gaetan-m11/TPI_TIME_TIMER/README.md

# TIME TIMER

## Description
Minuteur électronique réalisé dans le cadre d'un TPI

## Image
Capture d'écran 1

## Auteur
### Gaëtan Michel
### DIVTEC - ELT
### ELT 3+1
### 31.05.2024
