gaetan-m11/TPI_TIME_TIMER/Altium Designs/Circuit LED statut/LED_BAT_drawing.pdf

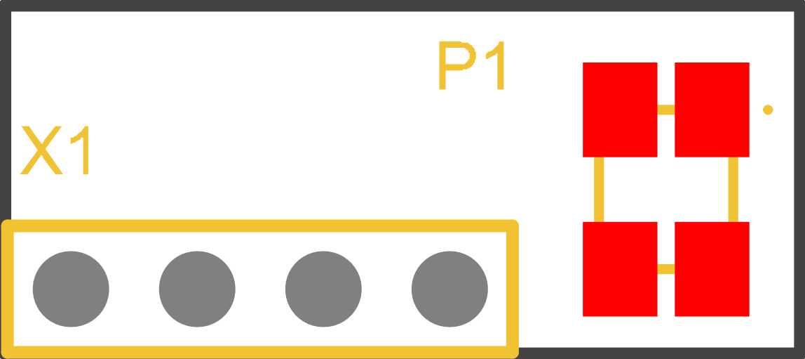
[picture p72: figure]
