gaetan-m11/TPI_TIME_TIMER/Documentation/Format PDF/TPI_Planning.pdf

ELT 3+1

# Planning TPI

Gaëtan Michel

S'informer | Lecture du CDC | initiale
| | Réel
| Recherche de solutions / composants | initiale
| | Réel
Absents, Maladie, … Planifier | création du Planning | initiale | Semaine 1 | Semaine 2 | Semaine 3 TPI
| | Réel
Décider | Choix de composant | initiale
| | Réel
| Définir forme/solution | initiale
| | Réel
| Commande de composant | initiale
| | Réel
Réaliser | Schéma Principal | initiale
| | Réel
| Montage sur plaque d'éssaie | initiale
| | Réel
| Programmation | initiale
| | Réel
| Réalisation de PCB | initiale
| | Réel
| Montage de composant | initiale
| | Réel
| Création / Impression du boitier | initiale
| | Réel
| Assemblage des éléments | initiale
| | Réel
| Mise en service | initiale
| | Réel
| Protocole de test | initiale
| | Réel
| Dépannage | initiale
| | Réel
Évaluation | Auto-évaluation | initiale
| | Réel
Documentation | Rapport | initiale
| | Réel
| Journaux de travail | initiale
| | Réel
| Mode d'emploi | initiale
| | Réel
| | | | | Semaine 4 | Semaine 5 | Semaine 6 | Semaine 7
Lundi Mercredi Jeudi | Férié | Date | 15.04.2024 5h55 5h55 | 17.04.2024 7h25 13h20 | 18.04.2024 4h25 17h45 | 22.04.2024 5h55 23h40 | 24.04.2024 7h25 31h05 | 25.04.2024 4h25 35h30 | 29.04.2024 5h55 41h25 | 01.05.2024 Férié 41h25 | 02.05.2024 4h25 45h50 | 06.05.2024 5h55 51h45 | 08.05.2024 7h25 59h10 | 09.05.2024 Férié 59h10 | 13.05.2024 5h55 65h05 | 15.05.2024 7h25 72h30 | 16.05.2024 4h25 76h55 | 20.05.2024 Férié 76h55 | 22.05.2024 7h25 84h20 | 23.05.2024 4h25 88h55 | 27.05.2024 5h55 94h50 | 29.05.2024 7h25 102h15
Temps par jour
Temps écoulé

Planning réel

planning prévu
