gaetan-m11/TPI_TIME_TIMER/CAO/couvercle.stp

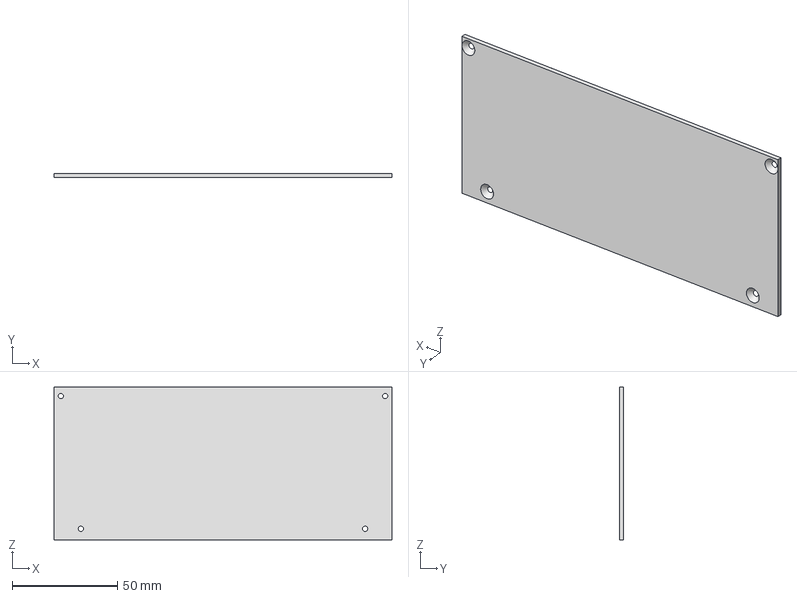
[picture p73: CAD file, 2024-05-30]
CAO/couvercle.stp
160.5 x 2.00 x 72.5 mm
