gaetan-m11/TPI_TIME_TIMER/CAO/ROULETTE.stp

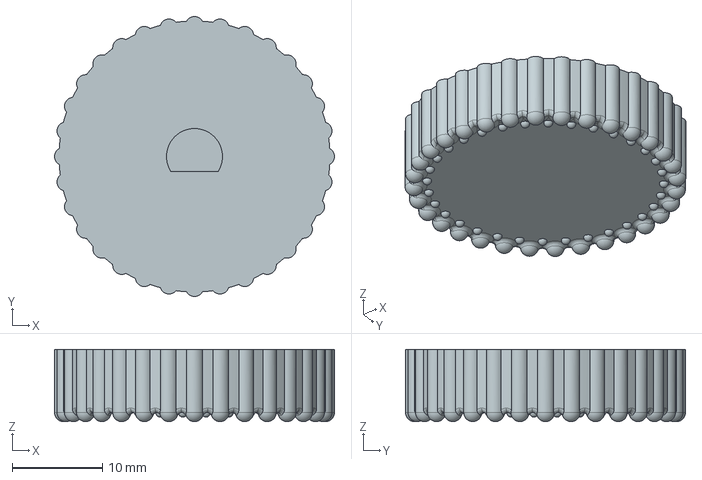
[picture p74: CAD file, 2024-05-30]
CAO/ROULETTE.stp
31.0 x 31.0 x 8.00 mm
