gaetan-m11/TPI_TIME_TIMER/CAO/base.stp

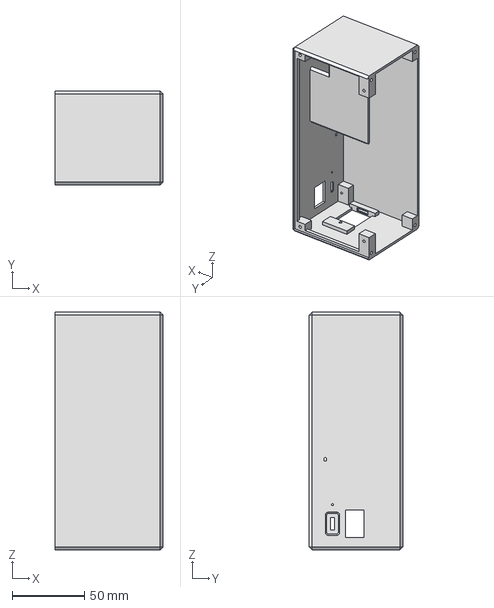
[picture p75: CAD file, 2024-05-30]
CAO/base.stp
75.0 x 65.0 x 165.0 mm
