gaetan-m11/TPI_TIME_TIMER/CAO/face_frontale.stp

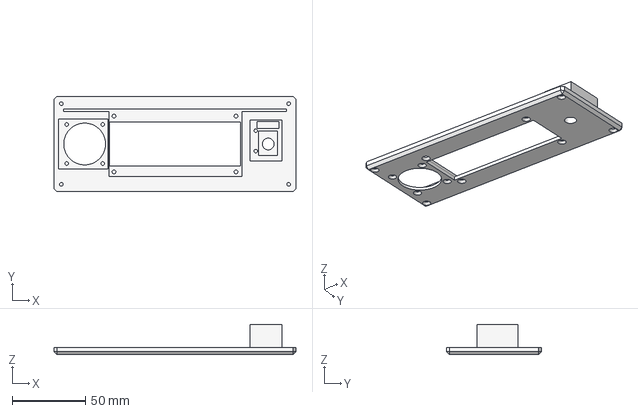
[picture p76: CAD file, 2024-05-30]
CAO/face_frontale.stp
165.0 x 65.0 x 20.7 mm
