gaetan-m11/TPI_TIME_TIMER/CAO/trappe.stp

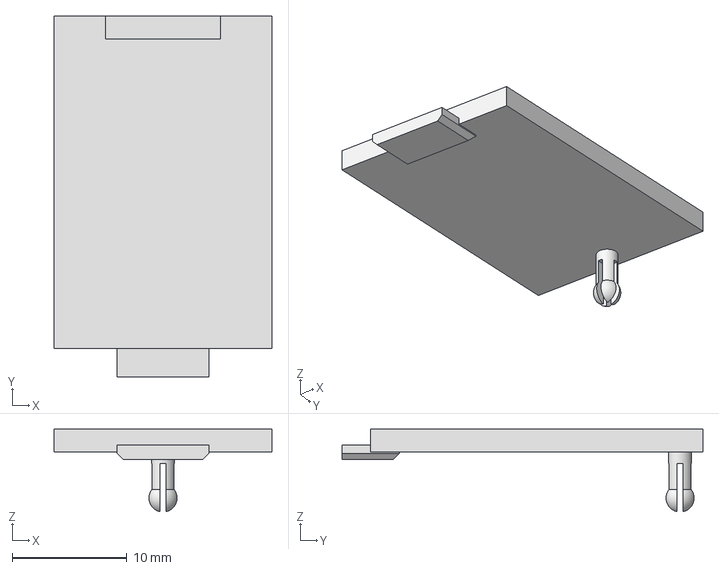
[picture p77: CAD file, 2024-05-30]
CAO/trappe.stp
19.0 x 31.5 x 7.20 mm
