gaetan-m11/TPI_TIME_TIMER/(list of files, cad)

Other CAD files:
CAO/ROULETTE.ipt
CAO/ROULETTE.stl
CAO/base.ipt
CAO/base.stl
CAO/couvercle.ipt
CAO/couvercle.stl
CAO/face_frontale.ipt
CAO/face_frontale.stl
CAO/trappe.ipt
CAO/trappe.stl
