gaetan-m11/TPI_TIME_TIMER/Documentation/Format PDF/TPI_Document_de_fabrication.pdf

ELT3+1 | Gaëtan Michel

# DOCUMENT DE FABRICATION

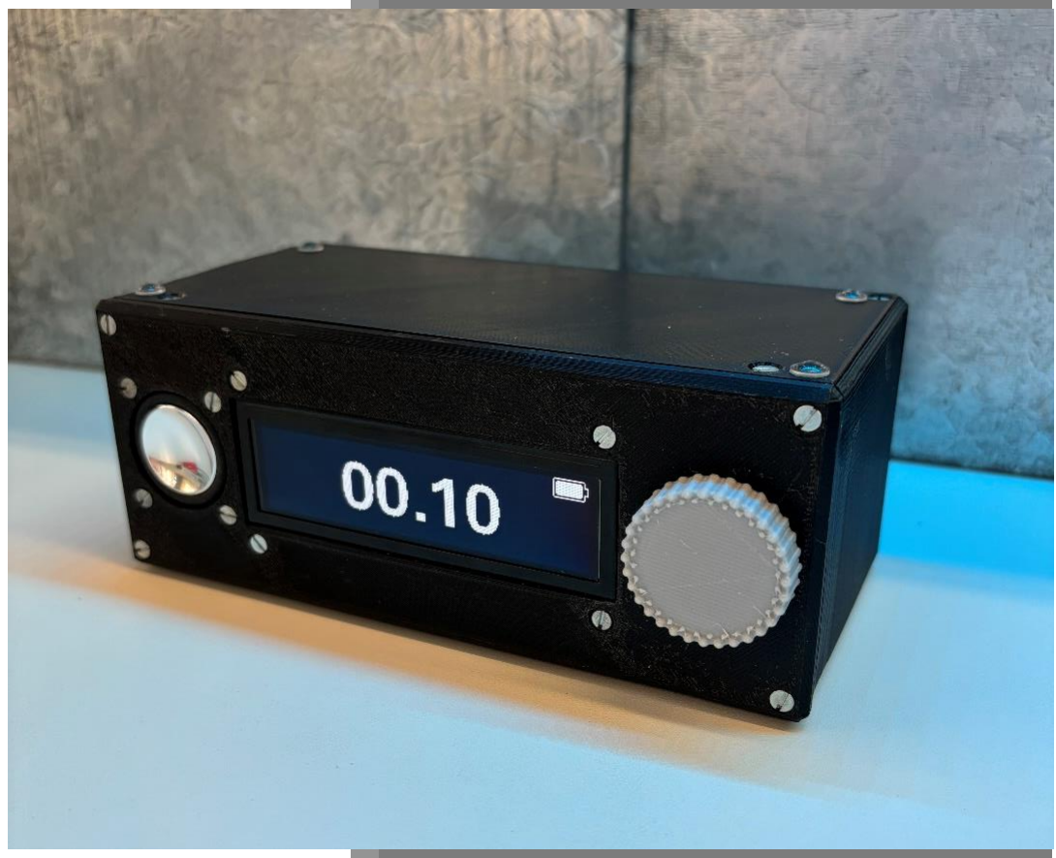
[picture p78: figure]

### Michel Gaëtan DIVTEC - ELT

31/05/2024

# TPI TIME TIMER

## Table des matières

# 1. Schémas électriques

## 1.1 Circuit principal

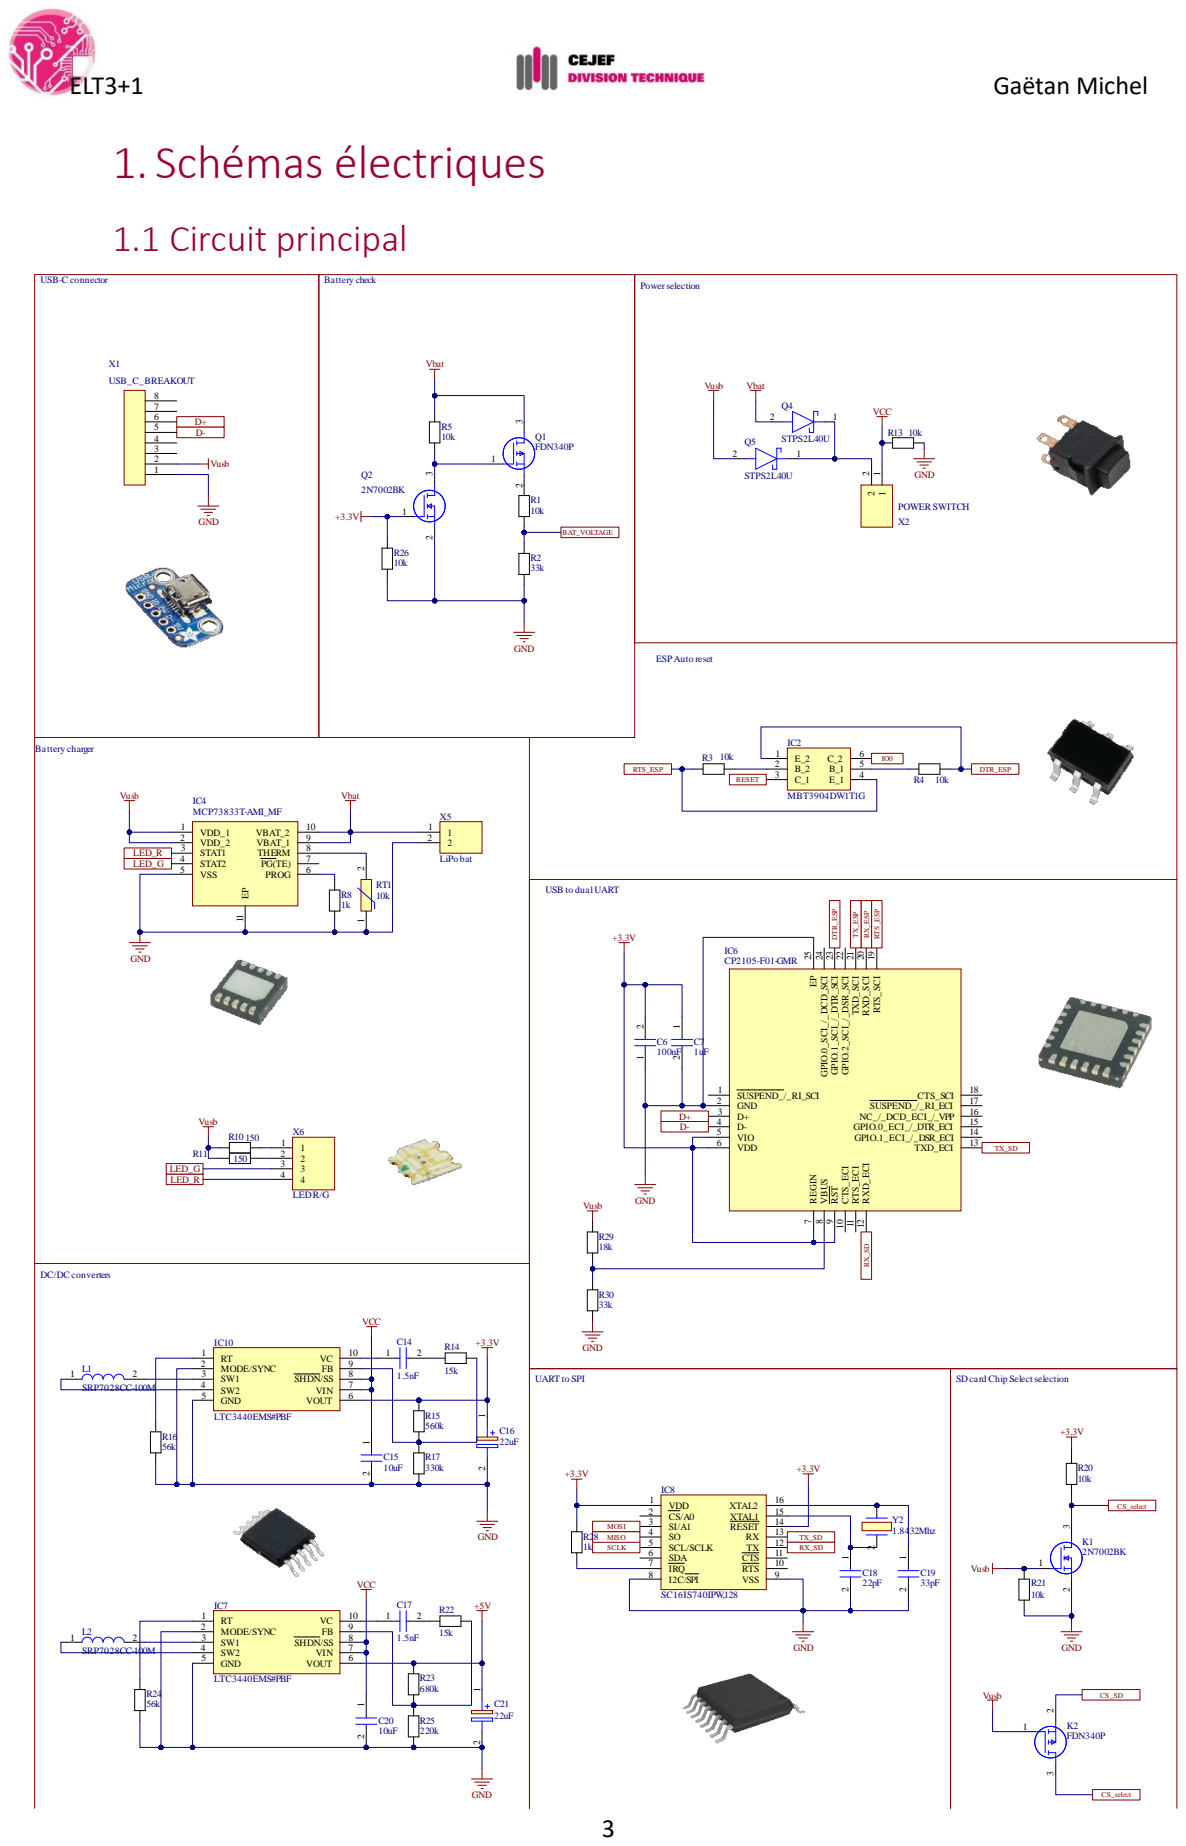
[picture p79: page 3]

USB to dual UART

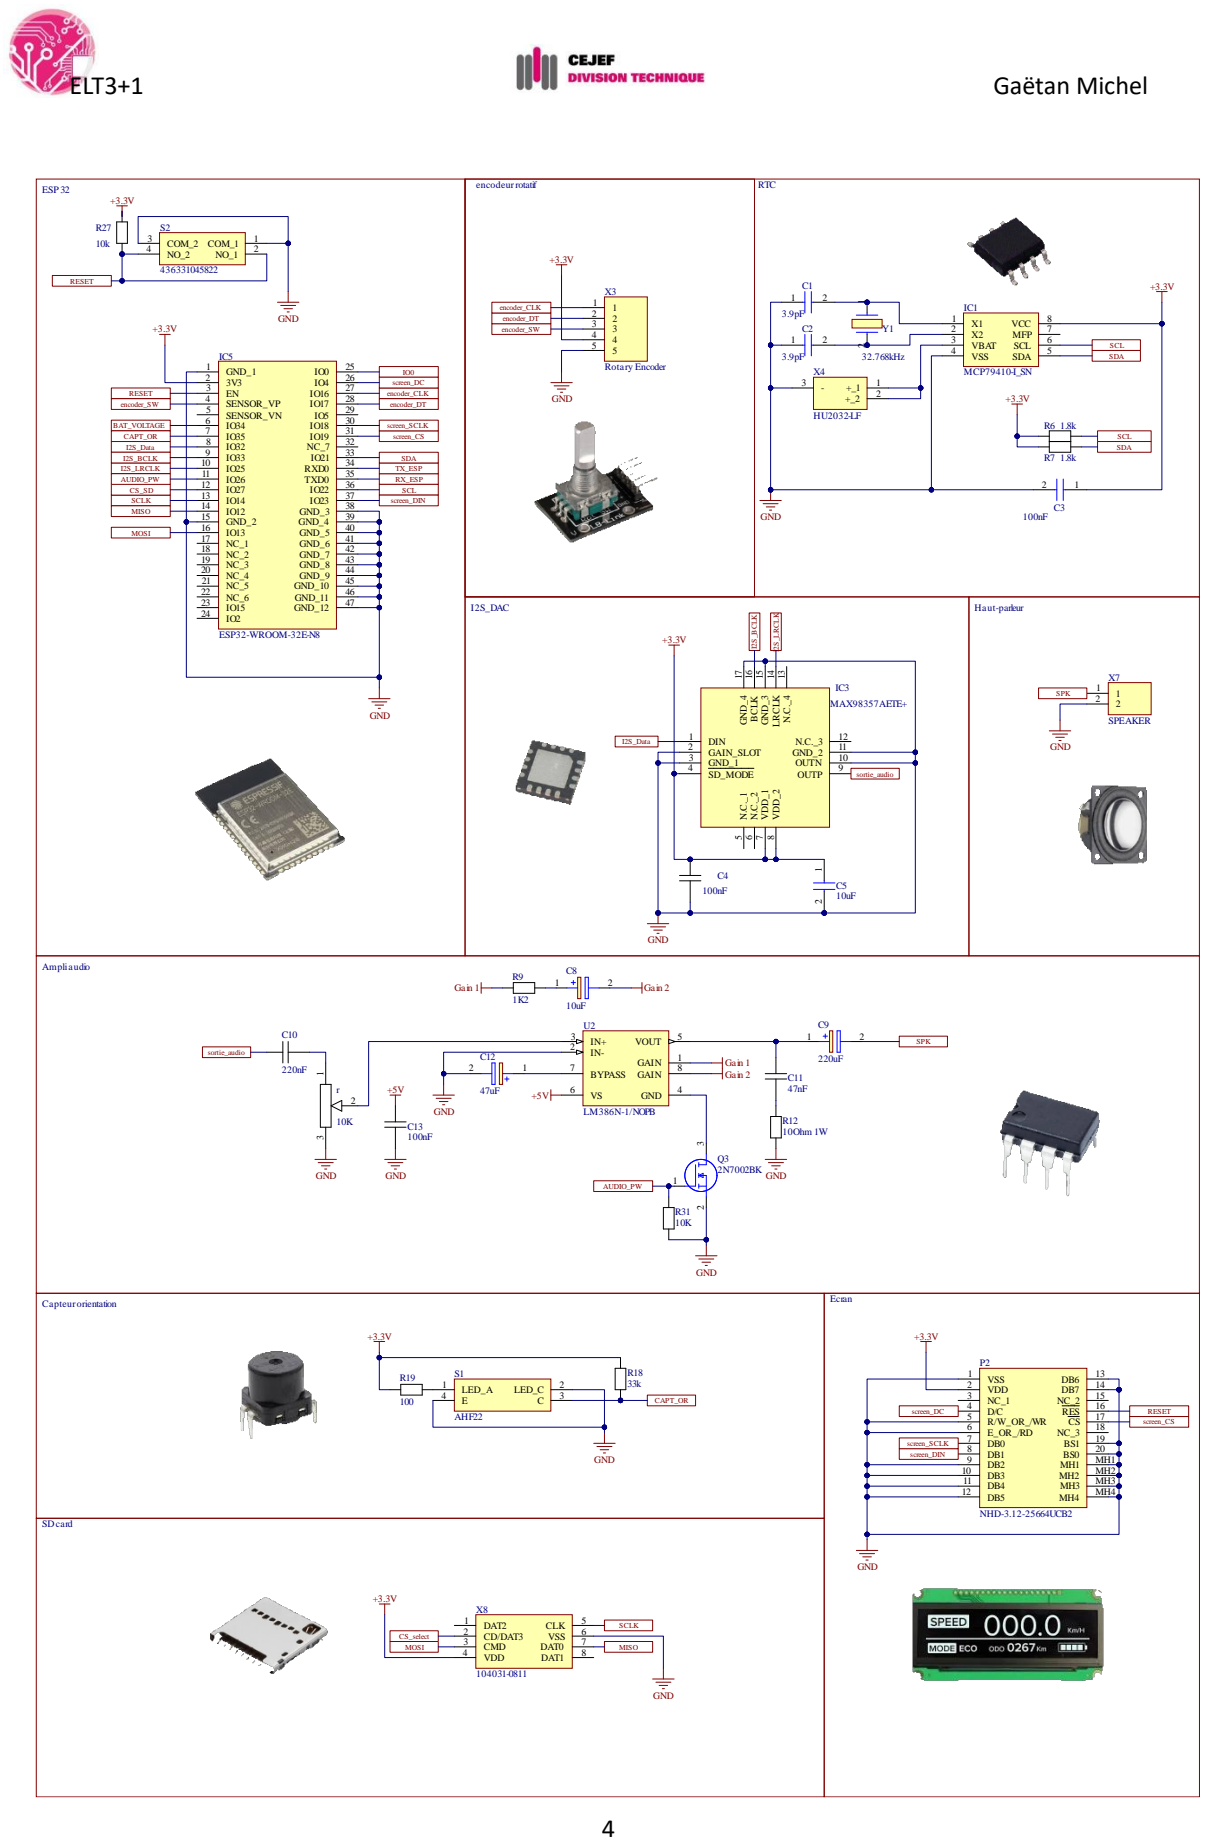
[picture p80: page 4]

## 1.2 Circuit LED de statut

A_YG 1

K_YG 2
A_R 3

K_R 4

P1

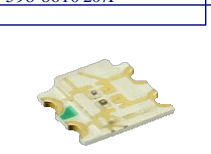
[picture p81: figure]

598-8610-207F

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
# 2. Montage des circuits imprimés

## 2.1 Circuit principal

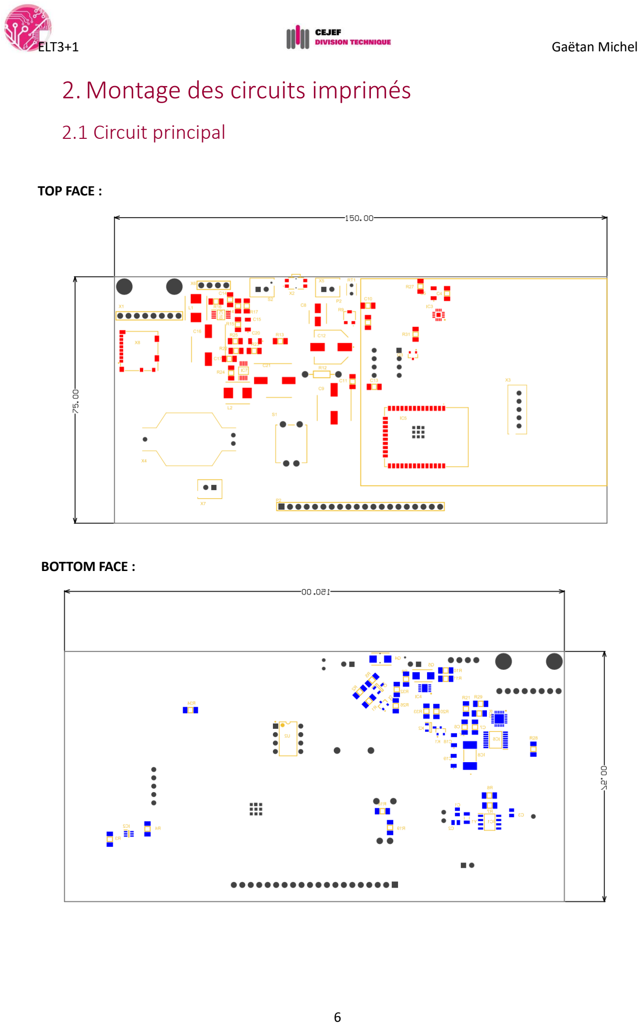
[picture p82: page 6]

TOP FACE :

BOTTOM FACE :

## 2.2 Circuit LED de statut

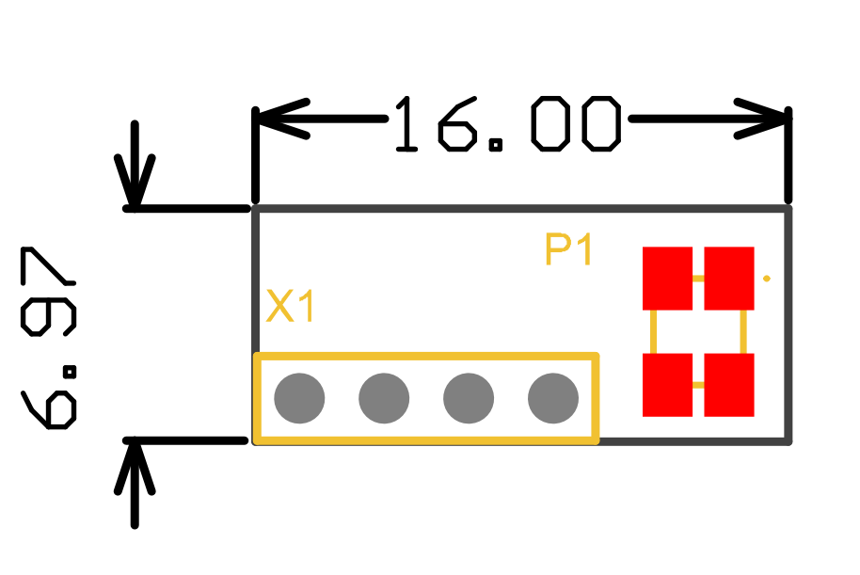
[picture p83: figure]

# 3. Fabrication du boitier

## 3.1 Face frontale

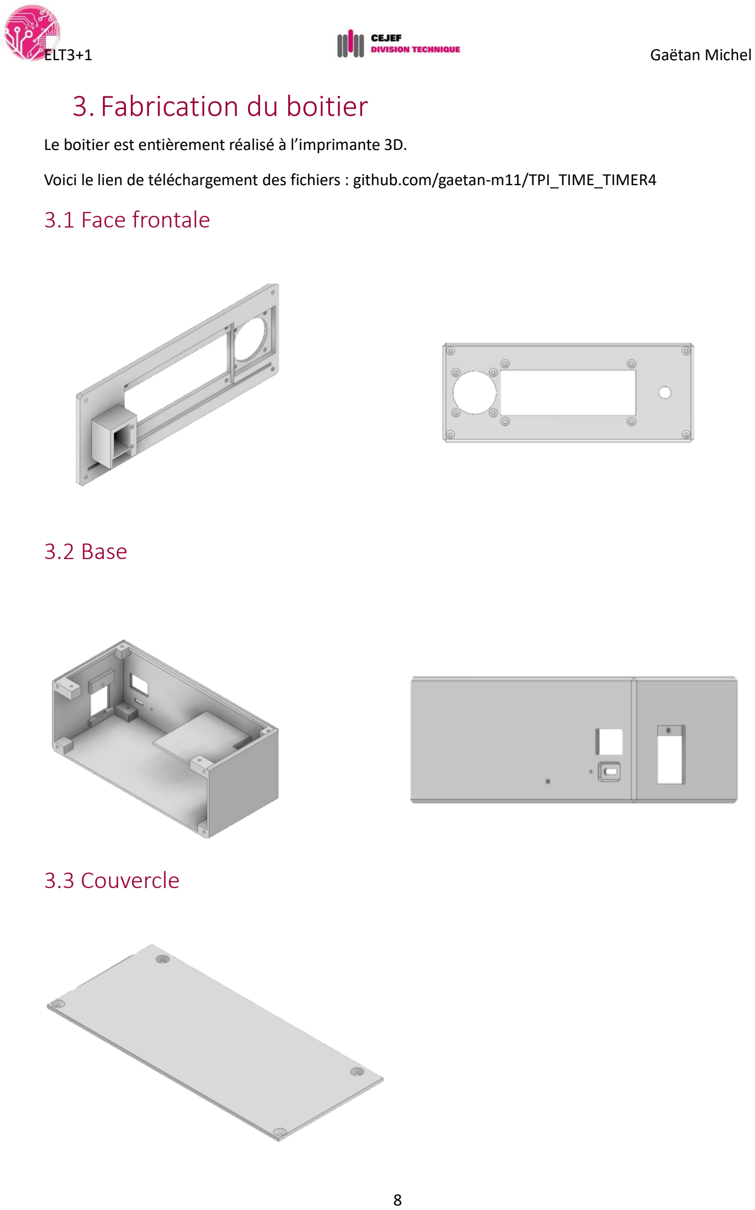
[picture p84: page 8]

Le boitier est entièrement réalisé à l’imprimante 3D.

Voici le lien de téléchargement des fichiers : github.com/gaetan-m11/TPI_TIME_TIMER4

## 3.2 Base

## 3.3 Couvercle

## 3.4 Trappe

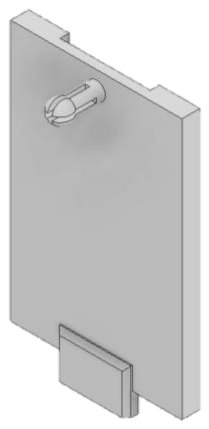
[picture p85: figure]

## 3.5 Roulette

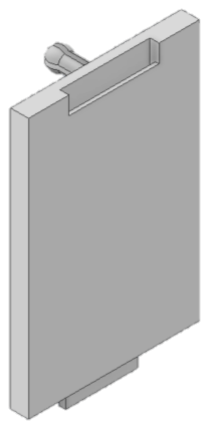
[picture p86: figure]
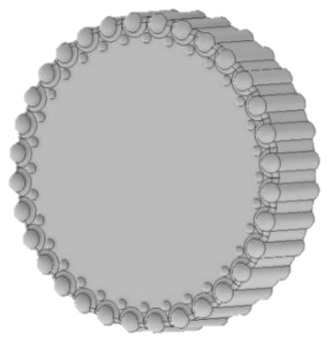
[picture p87: figure]
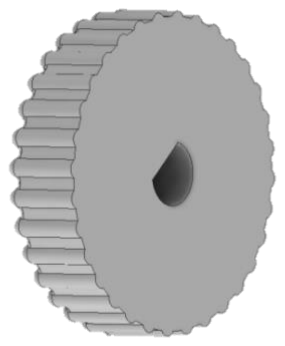
[picture p88: figure]

# 4. Montage de l’appareil

## 4.1 Assemblage de la face frontale

Commencer par braser l’écran et le circuit de la LED au circuit imprimé principal.

Fixer ensuite l’écran, le haut-parleur et l’encodeur rotatif et connecter ces deux derniers.

Ajouter également la pile 2032 pour la RTC.

Les vis utilisées sont des vis à tête fraisée M2.5x10mm et les écrous correspondants

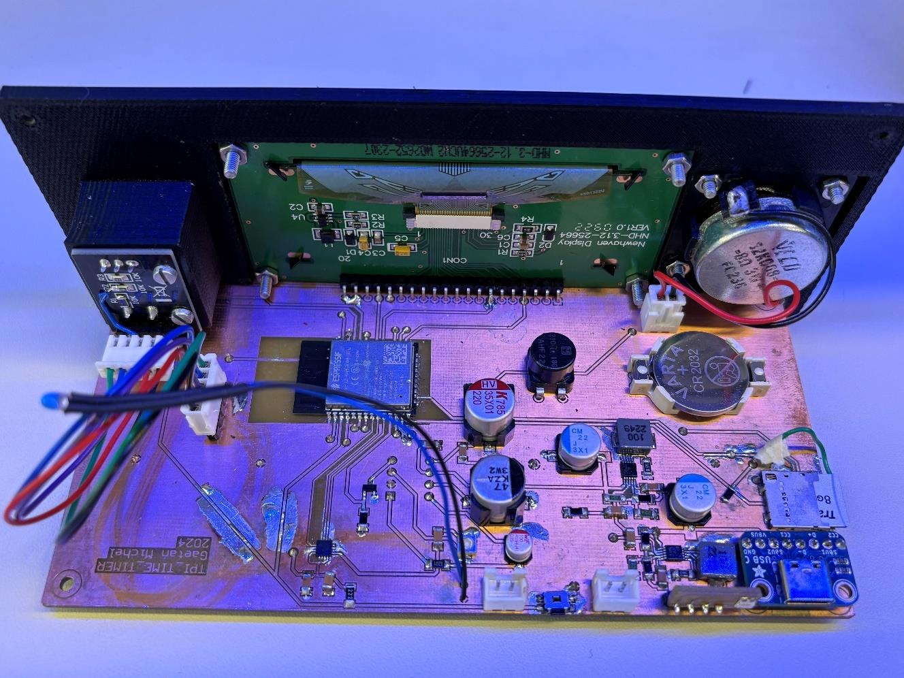
[picture p89: figure]

## 4.2 Assemblage des parties de boitier

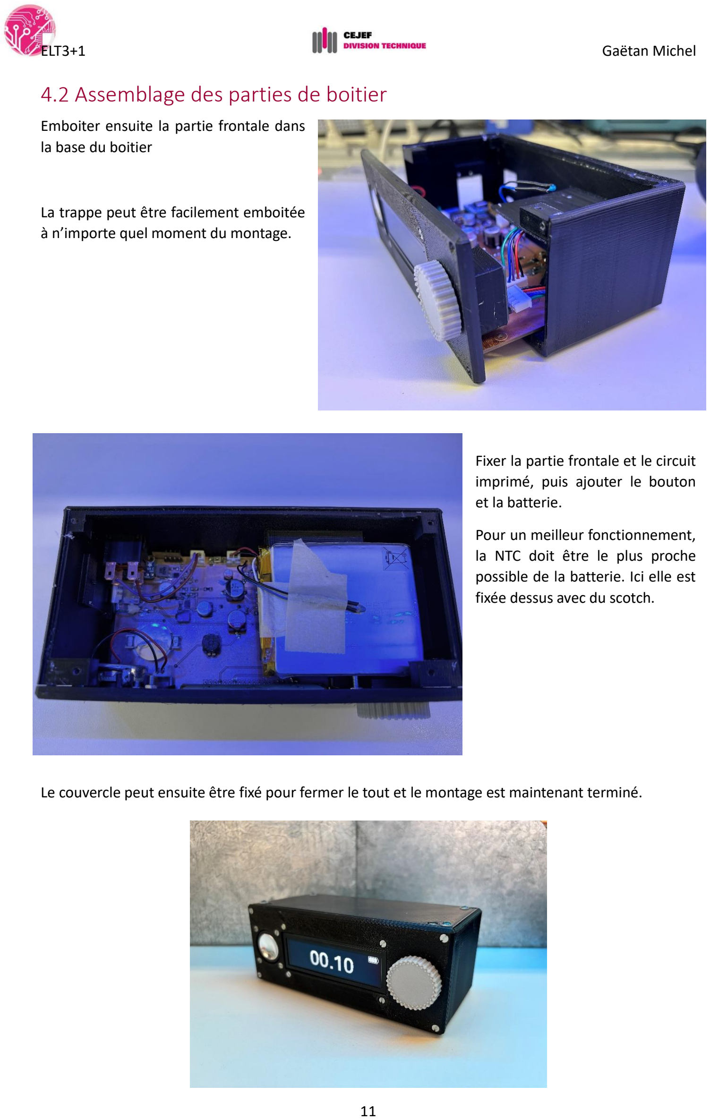
[picture p90: page 11]

Emboiter ensuite la partie frontale dans la base du boitier

La trappe peut être facilement emboitée à n’importe quel moment du montage.

Fixer la partie frontale et le circuit imprimé, puis ajouter le bouton et la batterie.

Pour un meilleur fonctionnement, la NTC doit être le plus proche possible de la batterie. Ici elle est fixée dessus avec du scotch.

Le couvercle peut ensuite être fixé pour fermer le tout et le montage est maintenant terminé.
