gaetan-m11/TPI_TIME_TIMER/Altium Designs/Circuit LED statut/LED_BAT_breakout.pdf

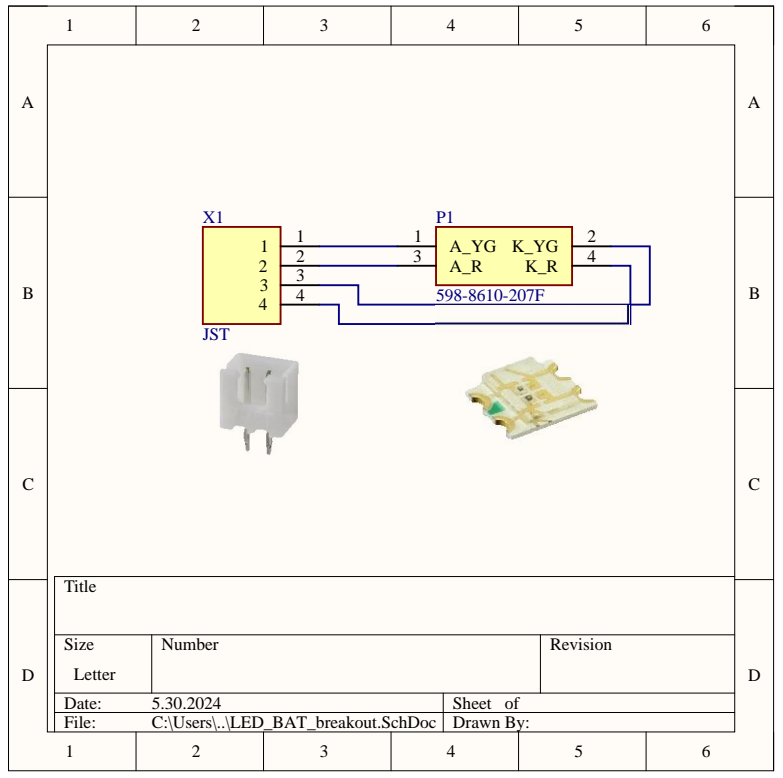
[picture p91: page 1]

Size Letter | Number | Revision

Date: 5.30.2024 | Sheet of
File: C:\Users\..\LED_BAT_breakout.SchDoc | Drawn By:

Comment | Description | Designator | Footprint | LibRef | Quantity
598-8610-207F | LED | P1 | 5988610207F | 598-8610-207F | 1
JST | Connector | X1 | Header 4pin2,54mm | B4B-XH-AM__LF__SN_ | 1
