gaetan-m11/TPI_TIME_TIMER/Altium Designs/Circuit principal/pcb_drawing.pdf

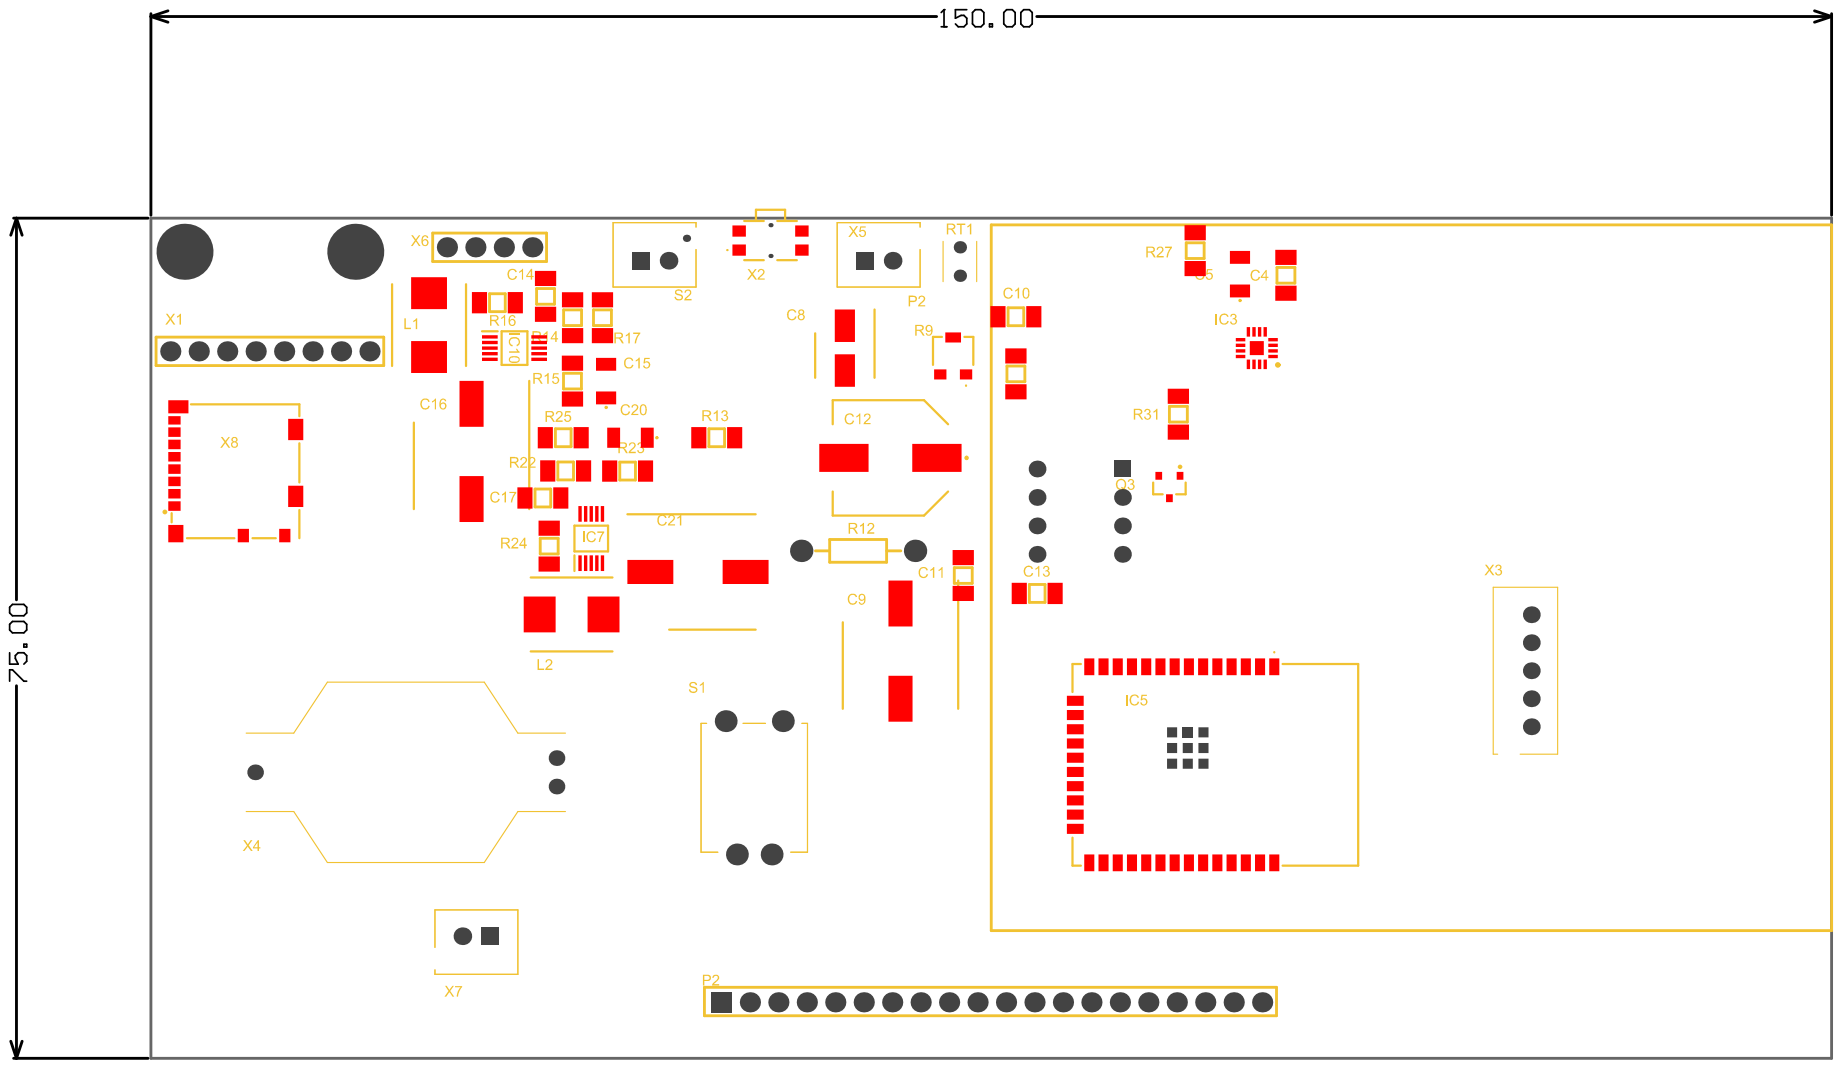
[picture p93: page 1]

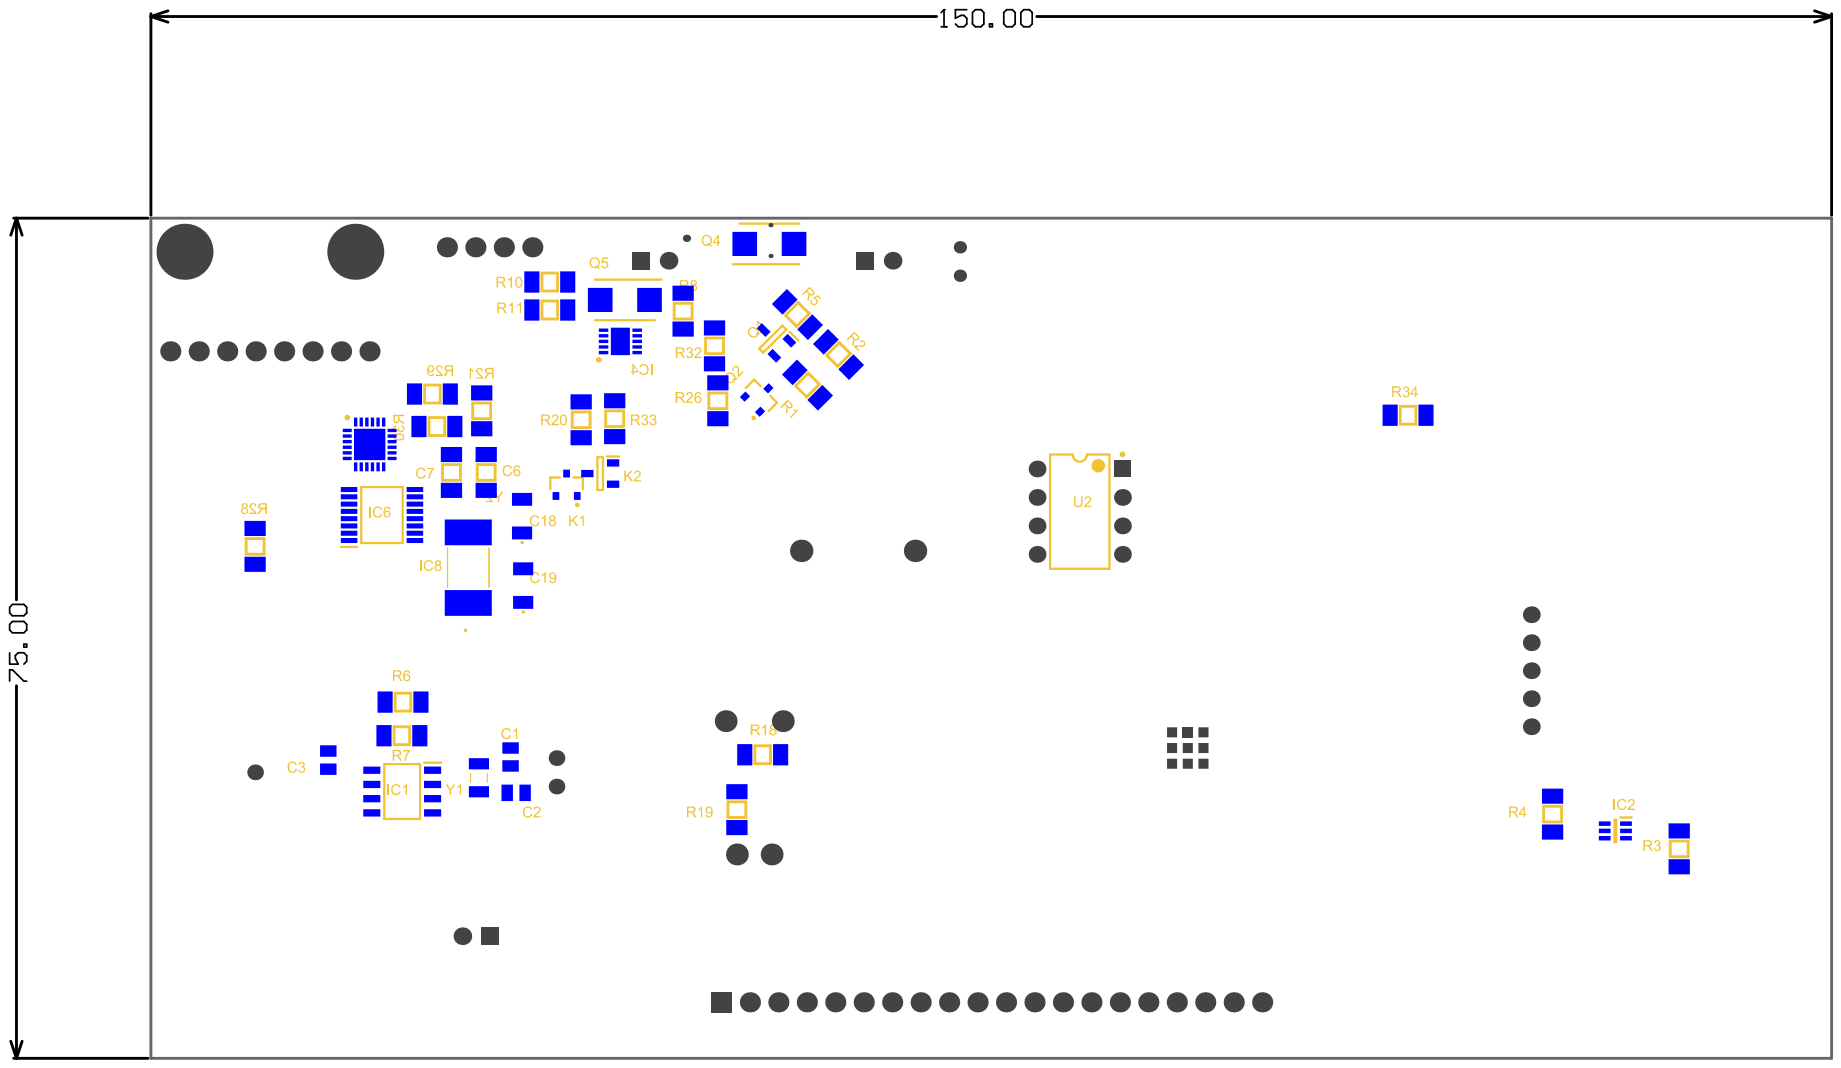
[picture p94: page 2]
