gaetan-m11/TPI_TIME_TIMER/(list of files, drawings)

Other design files:
Altium Designs/Circuit LED statut/LED_BAT_breakout/LED_BAT_breakout.PcbDoc
Altium Designs/Circuit LED statut/LED_BAT_breakout/LED_BAT_breakout.PcbLib
Altium Designs/Circuit LED statut/LED_BAT_breakout/LED_BAT_breakout.PrjPcb
Altium Designs/Circuit LED statut/LED_BAT_breakout/LED_BAT_breakout.SchDoc
Altium Designs/Circuit LED statut/LED_BAT_breakout/LED_BAT_breakout.SCHLIB
Altium Designs/Circuit principal/TPI_time_timer/TPI_time_timer.PcbLib
Altium Designs/Circuit principal/TPI_time_timer/TPI_time_timer.PrjPcb
Altium Designs/Circuit principal/TPI_time_timer/TPI_time_timer.SchDoc
Altium Designs/Circuit principal/TPI_time_timer/TPI_time_timer.SCHLIB
