gaetan-m11/TPI_TIME_TIMER/Arduino Code/Time_timer/bitmap.h

#ifndef BITMAP_DEF
#define BITMAP_DEF

#define bat_logo_width 28
#define bat_logo_height 28

#define FRAME_DELAY 5
#define FRAME_WIDTH 64
#define FRAME_HEIGHT 64
#define FRAME_COUNT 28

#define RINGTONE_GIF_WIDTH 48
#define RINGTONE_GIF_HEIGHT 48
#define RINGTONE_GIF_COUNT 28



const unsigned char bat_bitmap [] PROGMEM =  {
  0xf8, 0xff, 0xff, 0x00, 0x04, 0x00, 0x00, 0x01, 
  0x04, 0x00, 0x00, 0x01, 0x04, 0x00, 0x00, 0x01, 0x04, 0x00, 0x00, 0x07, 0x04, 0x00, 0x00, 0x04, 
  0x04, 0x00, 0x00, 0x04, 0x04, 0x00, 0x00, 0x04, 0x04, 0x00, 0x00, 0x04, 
	0x04, 0x00, 0x00, 0x07, 0x04, 0x00, 0x00, 0x01, 0x04, 0x00, 0x00, 0x01, 0x04, 0x00, 0x00, 0x01, 
	0xf8, 0xff, 0xff, 0x00, 0x00, 0x00, 0x00, 0x00, 0x00, 0x00, 0x00, 0x00, 0x00, 0x00, 0x00, 0x00, 
	0x00, 0x00, 0x00, 0x00, 0x00, 0x00, 0x00, 0x00, 0x00, 0x00, 0x00, 0x00, 0x00, 0x00, 0x00, 0x00,
	0x00, 0x00, 0x00, 0x00, 0x00, 0x00, 0x00, 0x00, 0x00, 0x00, 0x00, 0x00, 0x00, 0x00, 0x00, 0x00, 0x00, 0x00, 0x00, 0x00,
  0x00, 0x00, 0x00, 0x00, 0x00, 0x00, 0x00, 0x00
};

// 'image_2024-05-09_202627028', 48x48px
const unsigned char bat_logo_bitmap [] PROGMEM =  {
	0x00, 0x00, 0x00, 0x00, 0x00, 0x00, 0x00, 0x00, 0x00, 0x00, 0x00, 0x00, 0x00, 0x00, 0x00, 0x00, 
	0x00, 0x00, 0x00, 0x00, 0x00, 0x00, 0x00, 0x00, 0xe0, 0xff, 0xff, 0xff, 0x0f, 0x00, 0xf0, 0xff, 
	0xff, 0xff, 0x1f, 0x00, 0x30, 0x10, 0x00, 0x00, 0x3c, 0x00, 0x30, 0x10, 0x00, 0x00, 0x6c, 0x00, 
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
	0x00, 0x1e, 0x03, 0x00, 0x78, 0x00, 0x00, 0xbc, 0x03, 0x00, 0x3c, 0x00, 0x00, 0xf0, 0x01, 0x00, 
	0x0f, 0x00, 0x00, 0xc0, 0x07, 0xe0, 0x03, 0x00, 0x00, 0x00, 0xff, 0xff, 0x00, 0x00, 0x00, 0x00, 
	0xf8, 0x1f, 0x00, 0x00, 0x00, 0x00, 0x00, 0x00, 0x00, 0x00, 0x00, 0x00, 0x00, 0x00, 0x00, 0x00
};
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
